grantHarris/ProsthesisBatteryPack/LightPanels/DXF's/SBX connector outline - Right.DXF

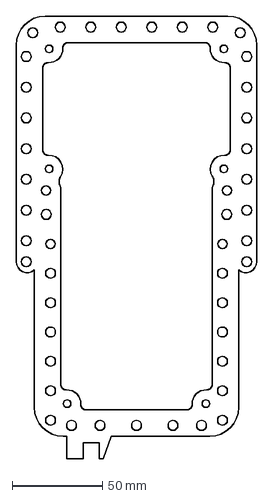
[picture p1: CAD file, 2016-11-01]
LightPanels/DXF's/SBX connector outline - Right.DXF
133.0 x 244.9 mm
