grantHarris/ProsthesisBatteryPack/LightPanels/DXF's/SBX connector outline - Left.DXF

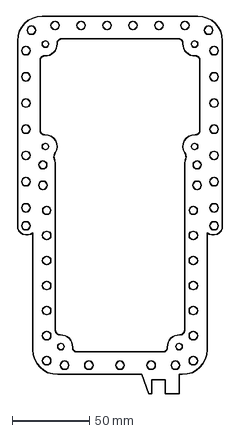
[picture p2: CAD file, 2016-11-01]
LightPanels/DXF's/SBX connector outline - Left.DXF
133.0 x 244.9 mm
