grantHarris/ProsthesisBatteryPack/LightPanels/DXF's/power indicator_right.DXF

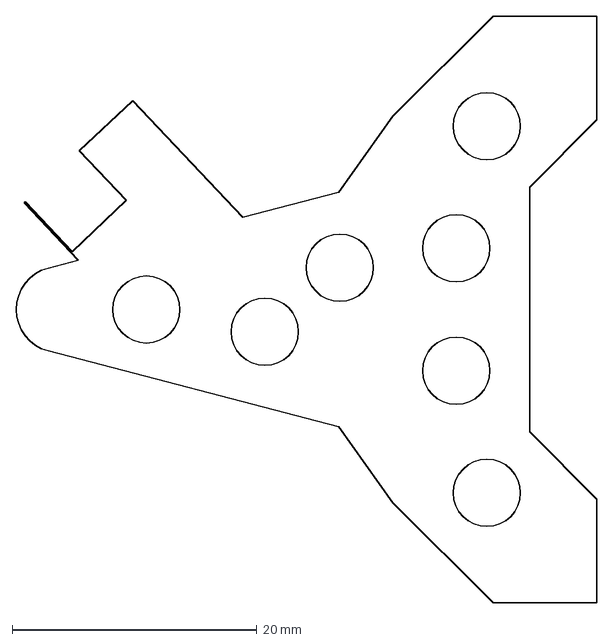
[picture p3: CAD file, 2016-11-01]
LightPanels/DXF's/power indicator_right.DXF
47.5 x 48.0 mm
