grantHarris/ProsthesisBatteryPack/LightPanels/DXF's/SOC level indicator.DXF

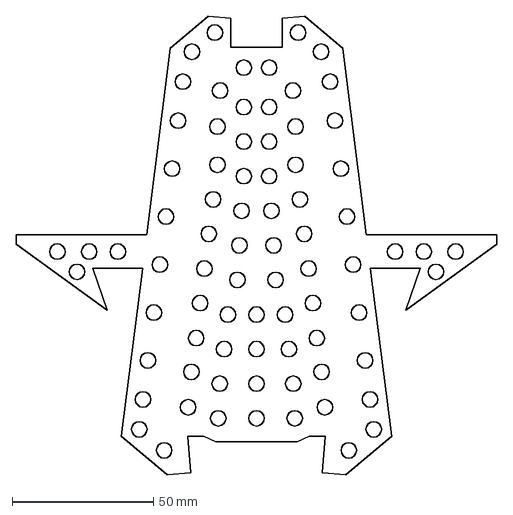
[picture p4: CAD file, 2016-11-01]
LightPanels/DXF's/SOC level indicator.DXF
170.0 x 162.3 mm
