grantHarris/ProsthesisBatteryPack/LightPanels/DXF's/power indicator_left.DXF

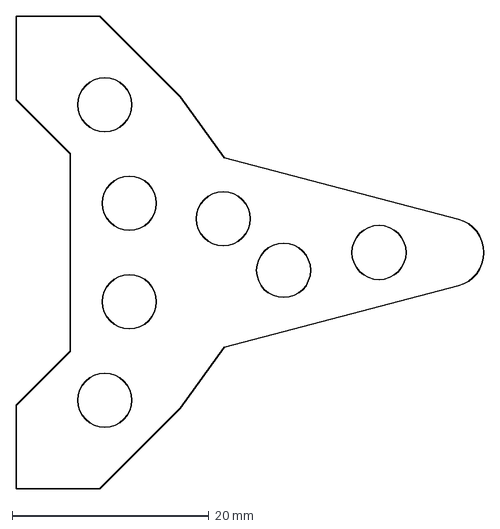
[picture p5: CAD file, 2016-11-01]
LightPanels/DXF's/power indicator_left.DXF
47.5 x 48.0 mm
