grantHarris/ProsthesisBatteryPack/CANShield/CANShield.brd

## EAGLE design CANShield/CANShield.brd (2016-12-07)

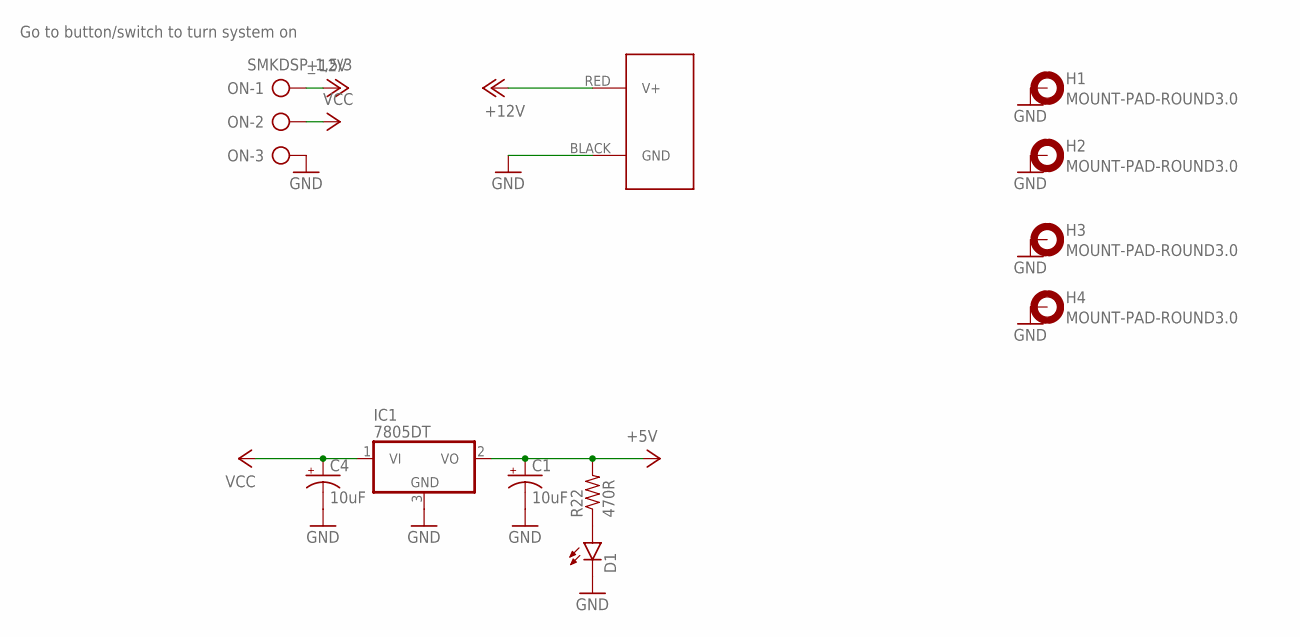
[picture p6: schematic CANShield.sch, sheet 1]

Parts:
C1, C4: 10uF; PANASONIC_C
D1: LED1206; LED-1206
H1, H2, H3, H4: MOUNT-PAD-ROUND3.0; 3,0-PAD
IC1: 7805DT; TO252
J2: POWERPOLE_POWER25A_HORIZONTAL_G2; POWERPOLE_PAIR_25A_HORIZ_G2
ON: SMKDSP_1,5/3
R22: 470R; 0603-RES

Connections:
+5V: C1.+, IC1.2 (VO), R22.2; also elsewhere on the board
+12V: J2.RED (V+), ON.1; also elsewhere on the board
GND: C1.-, C4.-, D1.C, H1.B3,0, H2.B3,0, H3.B3,0, H4.B3,0, IC1.3 (GND), J2.BLACK (GND), ON.3; also elsewhere on the board
unnamed: D1.A, R22.1
VCC: C4.+, IC1.1 (VI), ON.2

Notes on the sheet:
Go to button/switch to turn system on

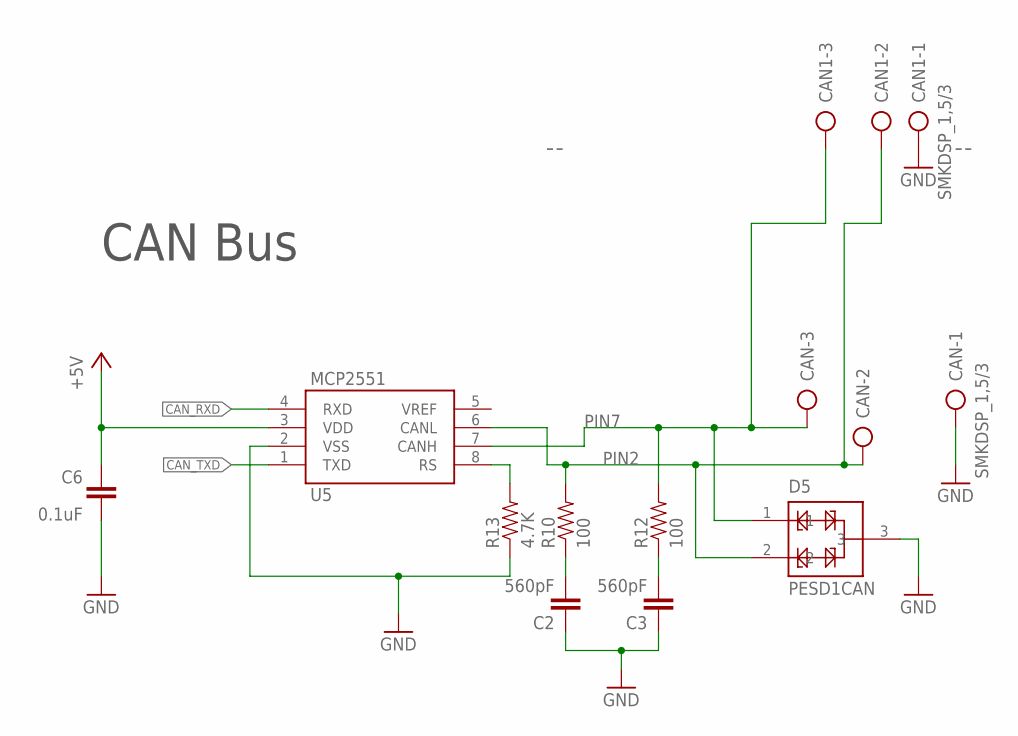
[picture p7: schematic CANShield.sch, sheet 2]

Parts:
C2, C3: 560pF; 0603-CAP
C6: 0.1uF; 0603-CAP
CAN, CAN1: SMKDSP_1,5/3
D5: PESD1CAN; SOT23-3@1
R10, R12: 100; 0603-RES@1
R13: 4.7K; 0603-RES@1
U5: MCP2551; SO08

Connections:
+5V: C6.2, U5.3 (VDD); also elsewhere on the board
CAN_RXD: U5.4 (RXD); also elsewhere on the board
CAN_TXD: U5.1 (TXD); also elsewhere on the board
GND: C2.1, C3.1, C6.1, CAN.1, CAN1.1, D5.3, R13.1, U5.2 (VSS); also elsewhere on the board
unnamed: C2.2, R10.1
unnamed: C3.2, R12.1
unnamed: R13.2, U5.8 (RS)
PIN2: CAN.2, CAN1.2, D5.2, R10.2, U5.6 (CANL)
PIN7: CAN.3, CAN1.3, D5.1, R12.2, U5.7 (CANH)

Notes on the sheet:
CAN Bus

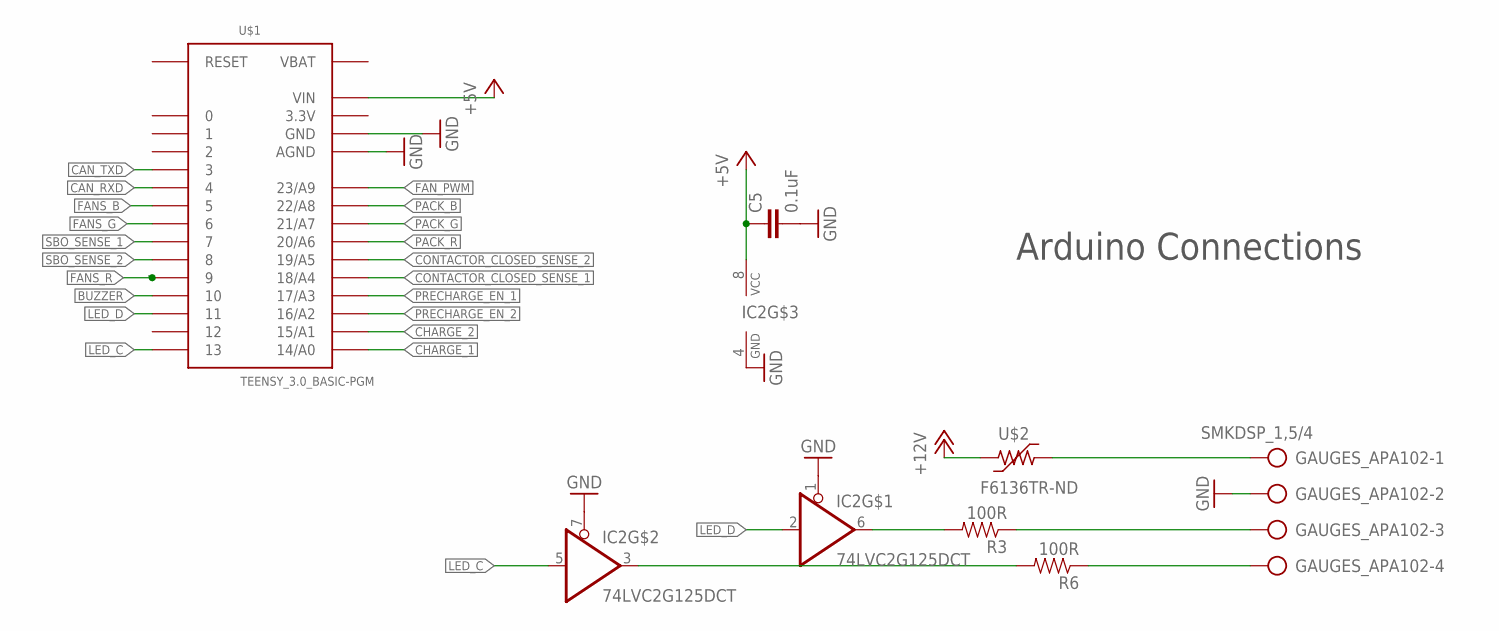
[picture p8: schematic CANShield.sch, sheet 3]

Parts:
C5: 0.1uF; 0603-CAP
GAUGES_APA102: SMKDSP_1,5/4
IC2: 74LVC2G125DCT; SSOP08
R3, R6: 100R; 0603-RES
U$1: TEENSY_3.0_BASIC-PGM
U$2: F6136TR-ND; 2920L

Connections:
3.3V: U$1.3.3V, U$1.3.3V1 (3.3V)
+5V: C5.1, IC2.8 (VCC), U$1.VIN; also elsewhere on the board
+12V: U$2.1; also elsewhere on the board
BUZZER: U$1.10; also elsewhere on the board
CAN_RXD: U$1.4; also elsewhere on the board
CAN_TXD: U$1.3; also elsewhere on the board
CHARGE_1: U$1.14/A0; also elsewhere on the board
CHARGE_2: U$1.15/A1; also elsewhere on the board
CONTACTOR_CLOSED_SENSE_1: U$1.18/A4; also elsewhere on the board
CONTACTOR_CLOSED_SENSE_2: U$1.19/A5; also elsewhere on the board
FANS_B: U$1.5; also elsewhere on the board
FANS_G: U$1.6; also elsewhere on the board
FANS_R: U$1.9; also elsewhere on the board
FAN_PWM: U$1.23/A9; also elsewhere on the board
GND: C5.2, GAUGES_APA102.2, IC2.1 (OE), IC2.4 (GND), IC2.7 (OE), U$1.AGND, U$1.GND, U$1.GND1 (GND); also elsewhere on the board
LED_C: IC2.5 (I), U$1.13
LED_D: IC2.2 (I), U$1.11
unnamed: IC2.3 (O), R6.2
unnamed: GAUGES_APA102.3, R3.1
unnamed: GAUGES_APA102.4, R6.1
unnamed: IC2.6 (O), R3.2
unnamed: GAUGES_APA102.1, U$2.2
PACK_B: U$1.22/A8; also elsewhere on the board
PACK_G: U$1.21/A7; also elsewhere on the board
PACK_R: U$1.20/A6; also elsewhere on the board
PRECHARGE_EN_1: U$1.17/A3; also elsewhere on the board
PRECHARGE_EN_2: U$1.16/A2; also elsewhere on the board
SBO_SENSE_1: U$1.7; also elsewhere on the board
SBO_SENSE_2: U$1.8; also elsewhere on the board
VBAT: U$1.VBAT

Notes on the sheet:
Arduino Connections

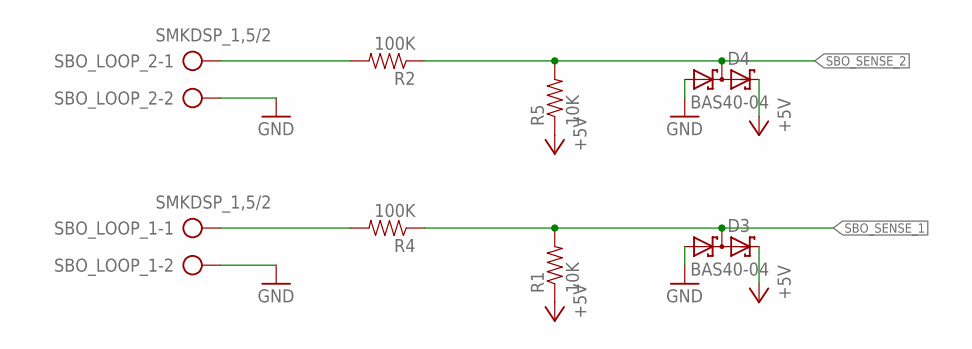
[picture p9: schematic CANShield.sch, sheet 4]

Parts:
D3, D4: BAS40-04; SOT23
R1, R5: 10K; 0603-RES
R2, R4: 100K; 0603-RES
SBO_LOOP_1, SBO_LOOP_2: SMKDSP_1,5/2

Connections:
+5V: D3.2 (C2), D4.2 (C2), R1.1, R5.1; also elsewhere on the board
GND: D3.1 (A1), D4.1 (A1), SBO_LOOP_1.2, SBO_LOOP_2.2; also elsewhere on the board
unnamed: R2.2, SBO_LOOP_2.1
unnamed: R4.2, SBO_LOOP_1.1
SBO_SENSE_1: D3.3 (C1A2), R1.2, R4.1; also elsewhere on the board
SBO_SENSE_2: D4.3 (C1A2), R2.1, R5.2; also elsewhere on the board

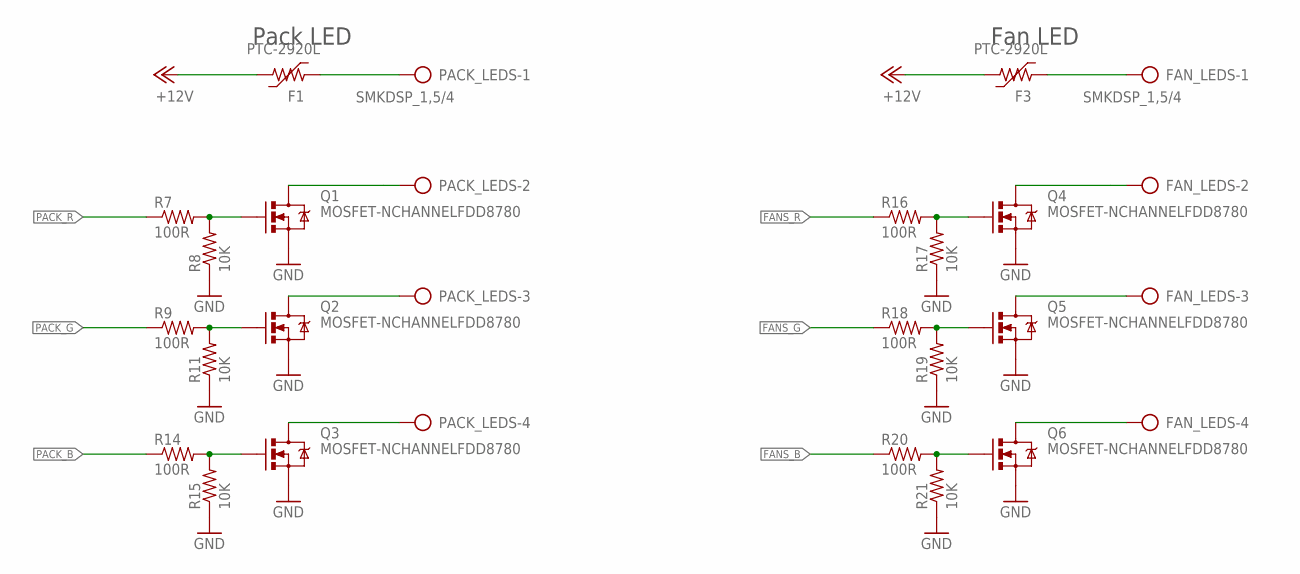
[picture p10: schematic CANShield.sch, sheet 5]

Parts:
F1, F3: PTC-2920L; 2920L
FAN_LEDS: SMKDSP_1,5/4
PACK_LEDS: SMKDSP_1,5/4
Q1, Q2, Q3, Q4, Q5, Q6: MOSFET-NCHANNELFDD8780; DPAK
R7, R9, R14, R16, R18, R20: 100R; 0603-RES
R8, R11, R15, R17, R19, R21: 10K; 0603-RES

Connections:
+12V: F1.2, F3.2; also elsewhere on the board
FANS_B: R20.1; also elsewhere on the board
FANS_G: R18.1; also elsewhere on the board
FANS_R: R16.1; also elsewhere on the board
GND: Q1.3 (S), Q2.3 (S), Q3.3 (S), Q4.3 (S), Q5.3 (S), Q6.3 (S), R8.1, R11.1, R15.1, R17.1, R19.1, R21.1; also elsewhere on the board
unnamed: PACK_LEDS.2, Q1.4 (D)
unnamed: F1.1, PACK_LEDS.1
unnamed: PACK_LEDS.3, Q2.4 (D)
unnamed: PACK_LEDS.4, Q3.4 (D)
unnamed: Q1.1 (G), R7.2, R8.2
unnamed: Q2.1 (G), R9.2, R11.2
unnamed: Q3.1 (G), R14.2, R15.2
unnamed: F3.1, FAN_LEDS.1
unnamed: FAN_LEDS.2, Q4.4 (D)
unnamed: FAN_LEDS.3, Q5.4 (D)
unnamed: FAN_LEDS.4, Q6.4 (D)
unnamed: Q4.1 (G), R16.2, R17.2
unnamed: Q5.1 (G), R18.2, R19.2
unnamed: Q6.1 (G), R20.2, R21.2
PACK_B: R14.1; also elsewhere on the board
PACK_G: R9.1; also elsewhere on the board
PACK_R: R7.1; also elsewhere on the board

Notes on the sheet:
Pack LED
Fan LED

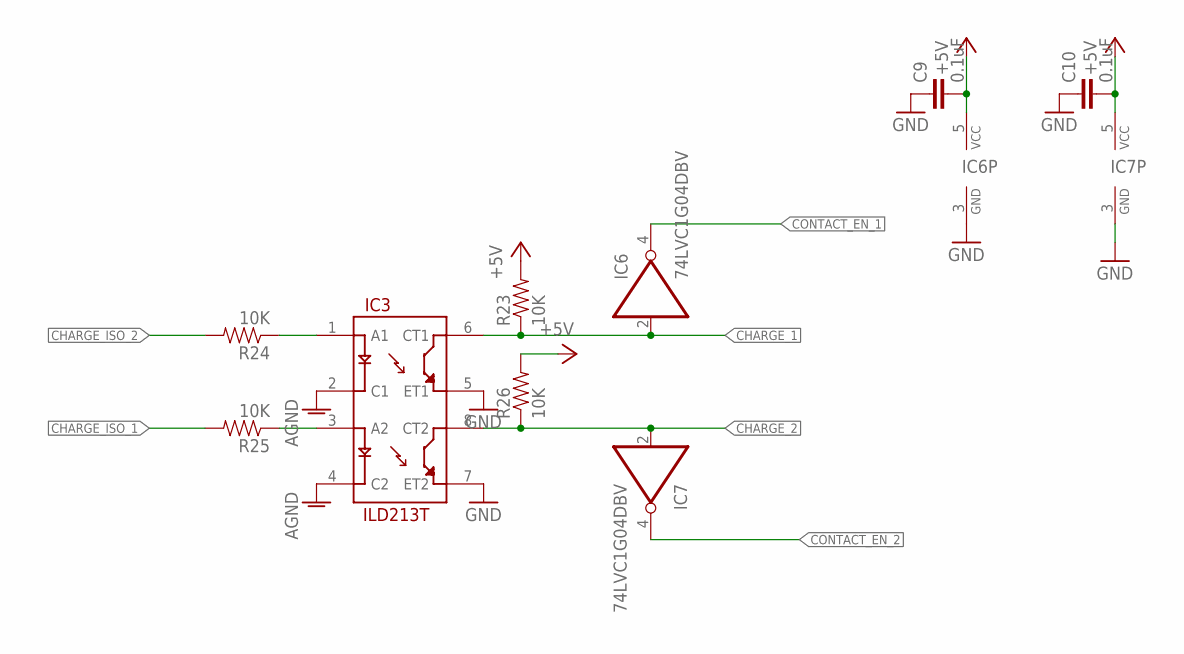
[picture p11: schematic CANShield.sch, sheet 6]

Parts:
C9, C10: 0.1uF; 0603-CAP
IC3: ILD213T; SO08
IC6, IC7: 74LVC1G04DBV; SOT23-5
R23, R24, R25, R26: 10K; 0603-RES

Connections:
+5V: C9.2, C10.2, IC6.5 (VCC), IC7.5 (VCC), R23.2, R26.2; also elsewhere on the board
AGND: IC3.2 (C1), IC3.4 (C2); also elsewhere on the board
CHARGE_1: IC3.6 (CT1), IC6.2 (I), R23.1; also elsewhere on the board
CHARGE_2: IC3.8 (CT2), IC7.2 (I), R26.1; also elsewhere on the board
CHARGE_ISO_1: R25.2; also elsewhere on the board
CHARGE_ISO_2: R24.2; also elsewhere on the board
CONTACT_EN_1: IC6.4 (O); also elsewhere on the board
CONTACT_EN_2: IC7.4 (O); also elsewhere on the board
GND: C9.1, C10.1, IC3.5 (ET1), IC3.7 (ET2), IC6.3 (GND), IC7.3 (GND); also elsewhere on the board
unnamed: IC3.3 (A2), R25.1
unnamed: IC3.1 (A1), R24.1

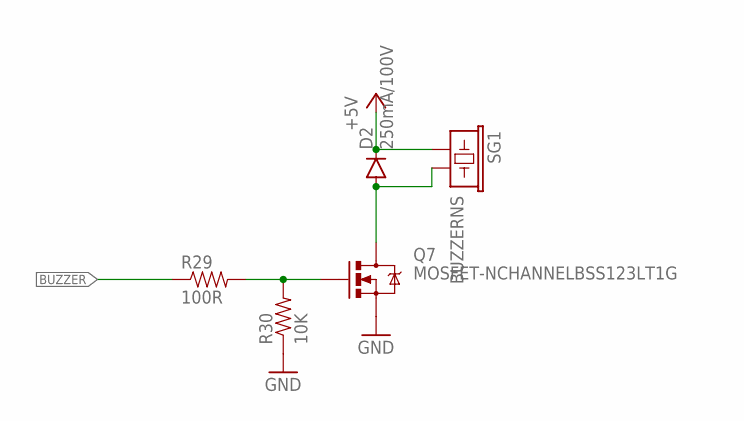
[picture p12: schematic CANShield.sch, sheet 7]

Parts:
D2: 250mA/100V; SOD-323
Q7: MOSFET-NCHANNELBSS123LT1G; SOT23
R29: 100R; 0603-RES
R30: 10K; 0603-RES
SG1: BUZZERNS; BUZZER-12MM-NS

Connections:
+5V: D2.C, SG1.+ (1); also elsewhere on the board
BUZZER: R29.1; also elsewhere on the board
GND: Q7.2 (S), R30.1; also elsewhere on the board
unnamed: D2.A, Q7.3 (D), SG1.- (2)
unnamed: Q7.1 (G), R29.2, R30.2

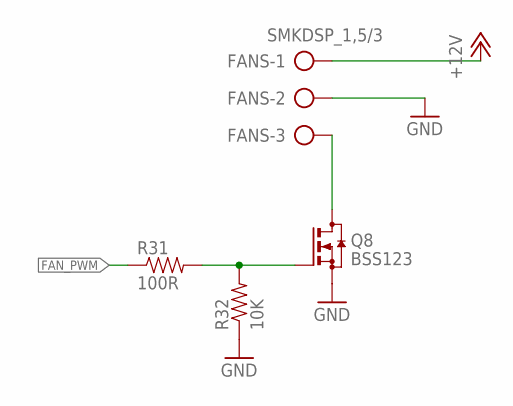
[picture p13: schematic CANShield.sch, sheet 8]

Parts:
FANS: SMKDSP_1,5/3
Q8: BSS123; SOT23
R31: 100R; 0603-RES
R32: 10K; 0603-RES

Connections:
+12V: FANS.1; also elsewhere on the board
FAN_PWM: R31.1; also elsewhere on the board
GND: FANS.2, Q8.2 (S), R32.1; also elsewhere on the board
unnamed: Q8.1 (G), R31.2, R32.2
unnamed: FANS.3, Q8.3 (D)

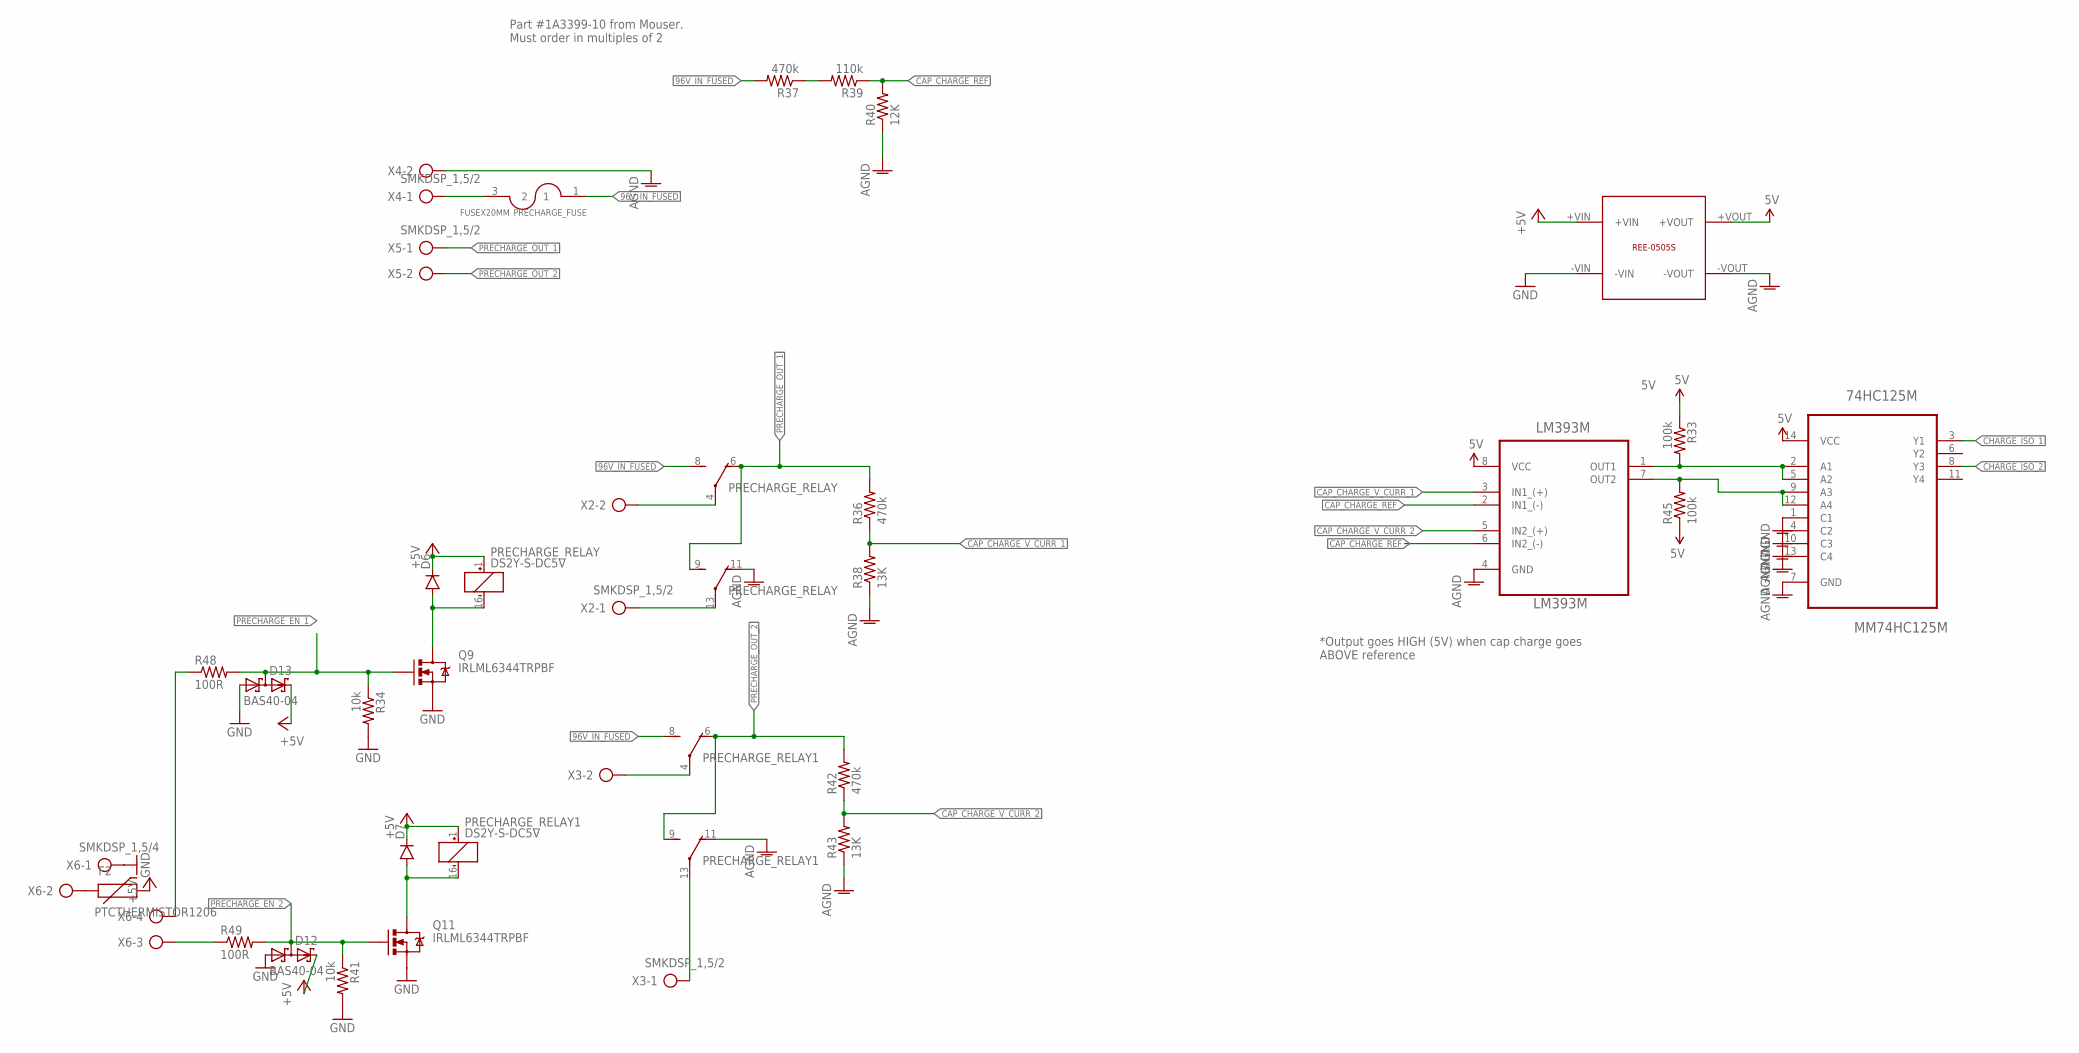
[picture p14: schematic CANShield.sch, sheet 9]

Parts:
74HC125M: MM74HC125M; SOIC127P600X175-14N
D6, D7: DIODESOD123; SOD-123
D12, D13: BAS40-04; SOT23
F2: PTCTHERMISTOR1206; PTC-1206
LM393M: LM393M; SOIC127P600X180-8N
PRECHARGE_FUSE: FUSEX20MM; FUSE_5MM
PRECHARGE_RELAY, PRECHARGE_RELAY1: DS2Y-S-DC5V; DS2Y
Q9, Q11: IRLML6344TRPBF; SOT23
R33, R45: 100k; 0603-RES
R34, R41: 10k; 0603-RES
R36, R37, R42: 470k; 0805
R38, R43: 13K; 0805
R39: 110k; 0805
R40: 12K; 0805
R48, R49: 100R; 0603-RES
U$5: REE-0505S
X2, X3, X4, X5: SMKDSP_1,5/2
X6: SMKDSP_1,5/4

Connections:
5V: 74HC125M.14 (VCC), LM393M.8 (VCC), R33.1, R45.1, U$5.+VOUT
96V_IN_FUSED: PRECHARGE_FUSE.1, PRECHARGE_RELAY.8 (S), PRECHARGE_RELAY1.8 (S), R37.2
+5V: D6.C, D7.C, D12.2 (C2), D13.2 (C2), F2.2, PRECHARGE_RELAY.1 (+), PRECHARGE_RELAY1.1 (+), U$5.+VIN; also elsewhere on the board
AGND: 74HC125M.1 (C1), 74HC125M.4 (C2), 74HC125M.7 (GND), 74HC125M.10 (C3), 74HC125M.13 (C4), LM393M.4 (GND), PRECHARGE_RELAY.11 (O), PRECHARGE_RELAY1.11 (O), R38.1, R40.1, R43.1, U$5.-VOUT, X4.2; also elsewhere on the board
CAP_CHARGE_REF: LM393M.2 (IN1_(-)), LM393M.6 (IN2_(-)), R39.1, R40.2
CAP_CHARGE_V_CURR_1: LM393M.3 (IN1_(+)), R36.1, R38.2
CAP_CHARGE_V_CURR_2: LM393M.5 (IN2_(+)), R42.1, R43.2
CHARGE_ISO_1: 74HC125M.3 (Y1); also elsewhere on the board
CHARGE_ISO_2: 74HC125M.8 (Y3); also elsewhere on the board
GND: D12.1 (A1), D13.1 (A1), Q9.2 (S), Q11.2 (S), R34.2, R41.2, U$5.-VIN, X6.1; also elsewhere on the board
unnamed: R37.1, R39.2
unnamed: 74HC125M.9 (A3), 74HC125M.12 (A4), LM393M.7 (OUT2), R45.2
unnamed: R48.1, X6.4
unnamed: R49.1, X6.3
unnamed: PRECHARGE_RELAY.13, X2.1
unnamed: PRECHARGE_RELAY1.13, X3.1
unnamed: PRECHARGE_FUSE.3 (2), X4.1
unnamed: F2.1, X6.2
PRECHARGE_EN_1: D13.3 (C1A2), Q9.1 (G), R34.1, R48.2; also elsewhere on the board
PRECHARGE_EN_2: D12.3 (C1A2), Q11.1 (G), R41.1, R49.2; also elsewhere on the board
PRECHARGE_OUT_1: PRECHARGE_RELAY.6 (O), PRECHARGE_RELAY.9 (S), R36.2, X5.1
PRECHARGE_OUT_2: PRECHARGE_RELAY1.6 (O), PRECHARGE_RELAY1.9 (S), R42.2, X5.2
PRECHARGE_RESISTOR_IN_1: PRECHARGE_RELAY.4, X2.2
PRECHARGE_RESISTOR_IN_2: PRECHARGE_RELAY1.4, X3.2
PRECH_DRAIN: D6.A, PRECHARGE_RELAY.16 (-), Q9.3 (D)
PRECH_DRAIN1: D7.A, PRECHARGE_RELAY1.16 (-), Q11.3 (D)
PRECH_STATE_TO_BUFF: 74HC125M.2 (A1), 74HC125M.5 (A2), LM393M.1 (OUT1), R33.2

Notes on the sheet:
*Output goes HIGH (5V) when cap charge goes ABOVE reference
Part #1A3399-10 from Mouser. Must order in multiples of 2

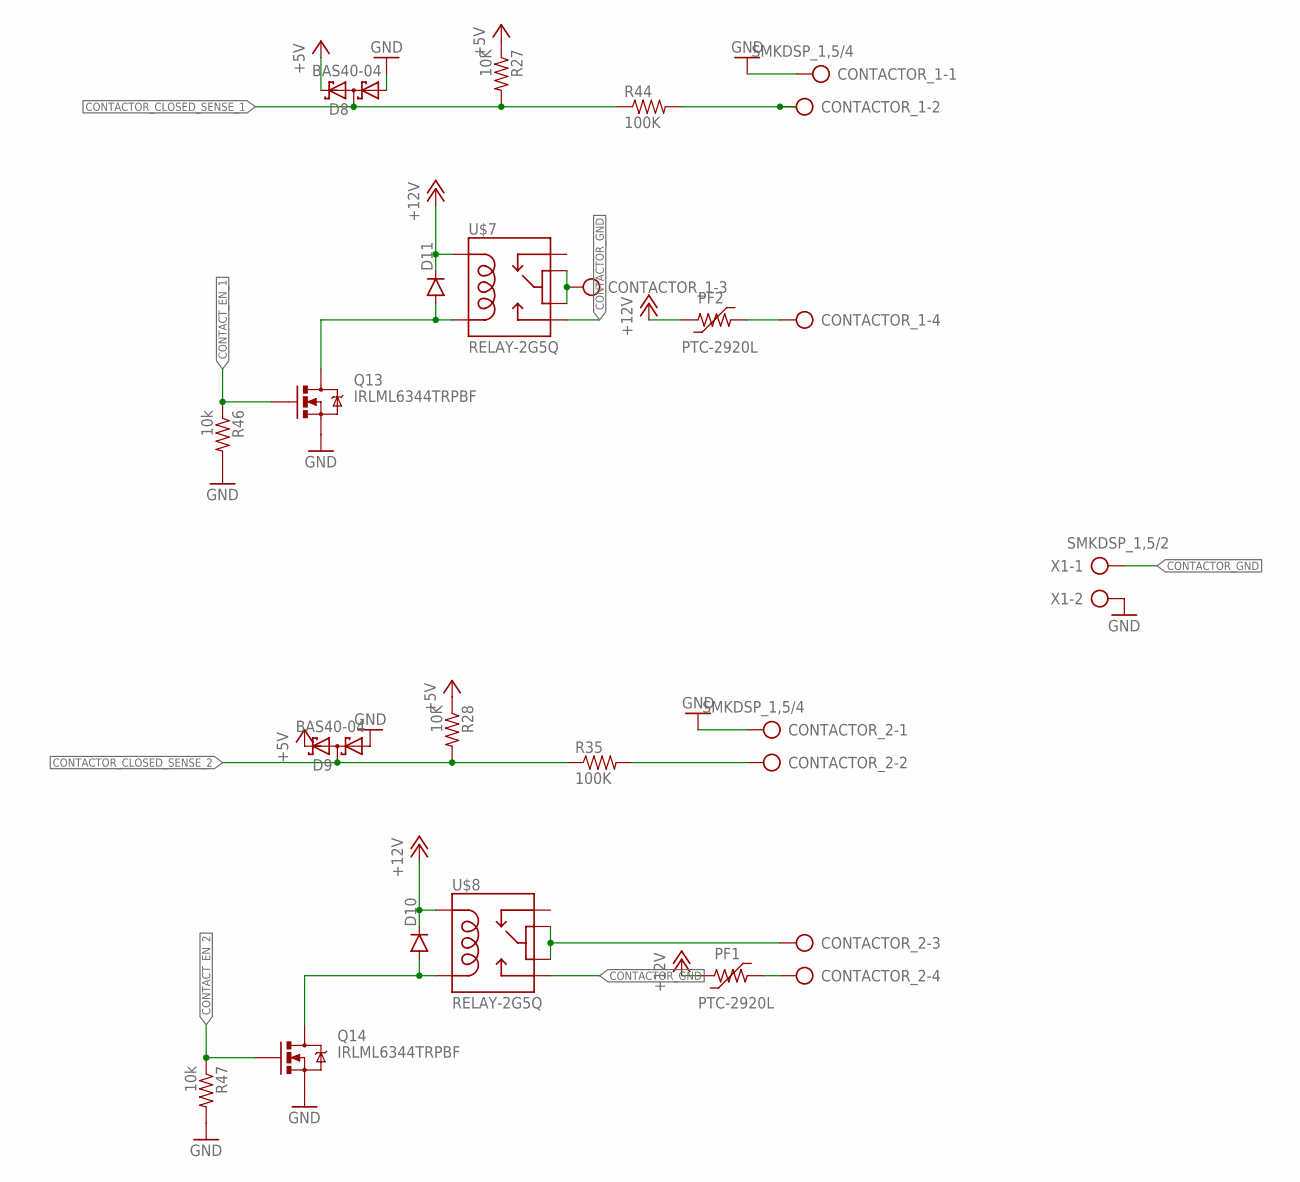
[picture p15: schematic CANShield.sch, sheet 10]

Parts:
CONTACTOR_1, CONTACTOR_2: SMKDSP_1,5/4
D8, D9: BAS40-04; SOT23
D10, D11: DIODESOD123; SOD-123
PF1, PF2: PTC-2920L; 2920L
Q13, Q14: IRLML6344TRPBF; SOT23
R27, R28: 10K; 0603-RES
R35, R44: 100K; 0603-RES
R46, R47: 10k; 0603-RES
U$7, U$8: RELAY-2G5Q; RELAY-G5V
X1: SMKDSP_1,5/2

Connections:
+5V: D8.2 (C2), D9.2 (C2), R27.1, R28.1; also elsewhere on the board
+12V: D10.C, D11.C, PF1.1, PF2.1, U$7.2, U$8.2; also elsewhere on the board
CONTACTOR_CLOSED_SENSE_1: D8.3 (C1A2), R27.2, R44.1; also elsewhere on the board
CONTACTOR_CLOSED_SENSE_2: D9.3 (C1A2), R28.2, R35.1; also elsewhere on the board
CONTACTOR_GND: U$7.10, U$8.10, X1.1
CONTACT_EN_1: Q13.1 (G), R46.1; also elsewhere on the board
CONTACT_EN_2: Q14.1 (G), R47.1; also elsewhere on the board
GND: CONTACTOR_1.1, CONTACTOR_2.1, D8.1 (A1), D9.1 (A1), Q13.2 (S), Q14.2 (S), R46.2, R47.2, X1.2; also elsewhere on the board
unnamed: D10.A, Q14.3 (D), U$8.9
unnamed: D11.A, Q13.3 (D), U$7.9
unnamed: CONTACTOR_1.3, U$7.5, U$7.6
unnamed: CONTACTOR_2.3, U$8.5, U$8.6
unnamed: CONTACTOR_1.4, PF2.2
unnamed: CONTACTOR_2.4, PF1.2
unnamed: CONTACTOR_2.2, R35.2
unnamed: CONTACTOR_1.2, R44.2

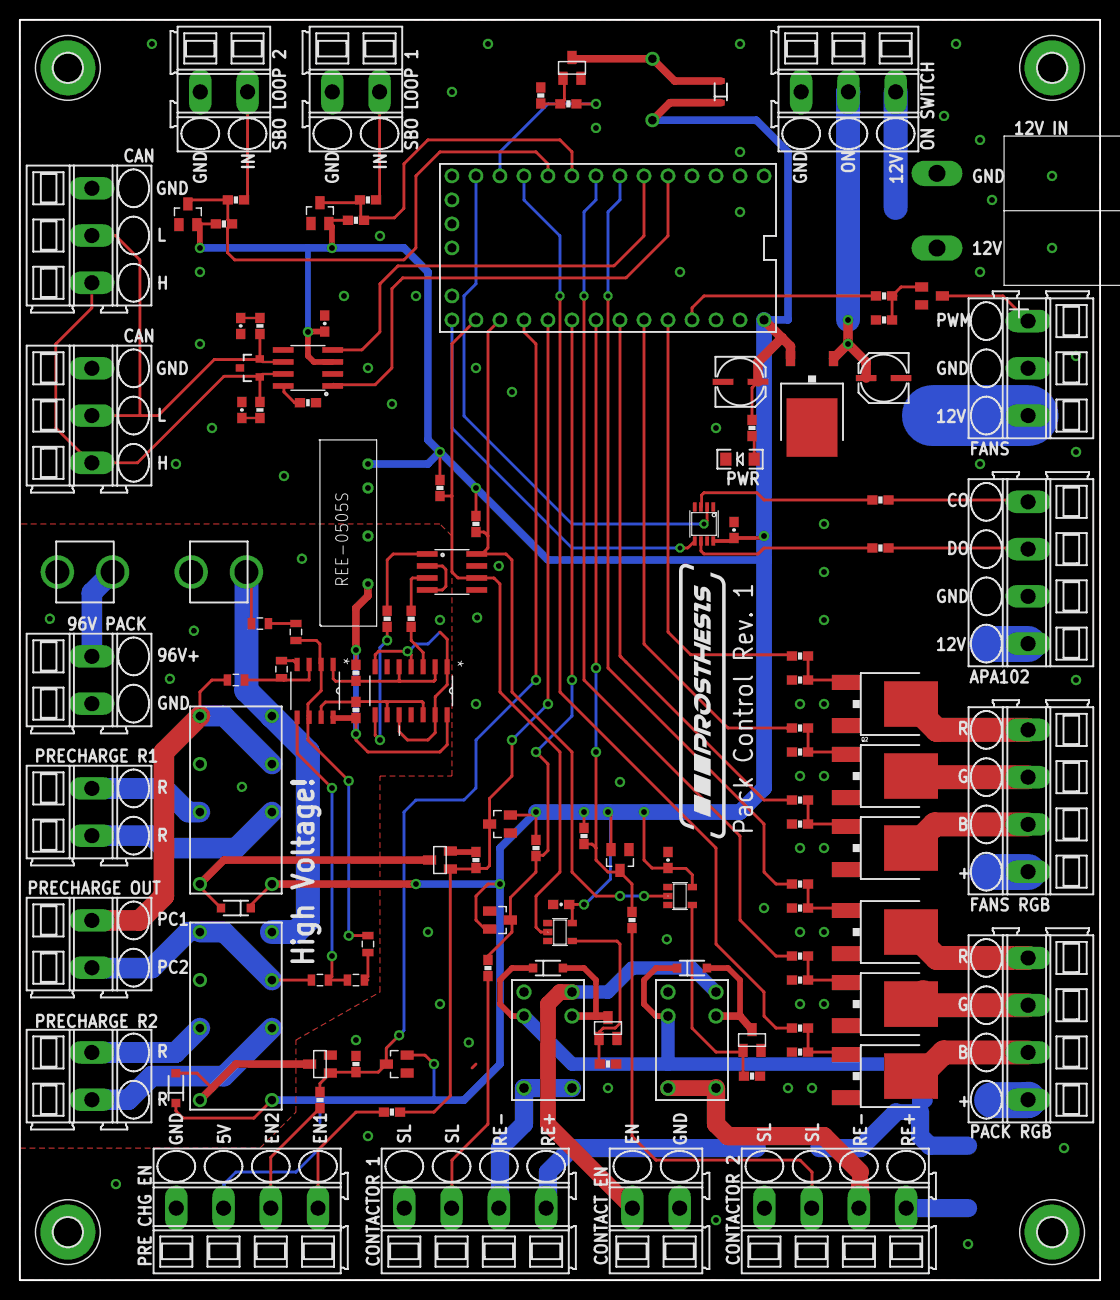
[picture p16: board CANShield.brd from above]

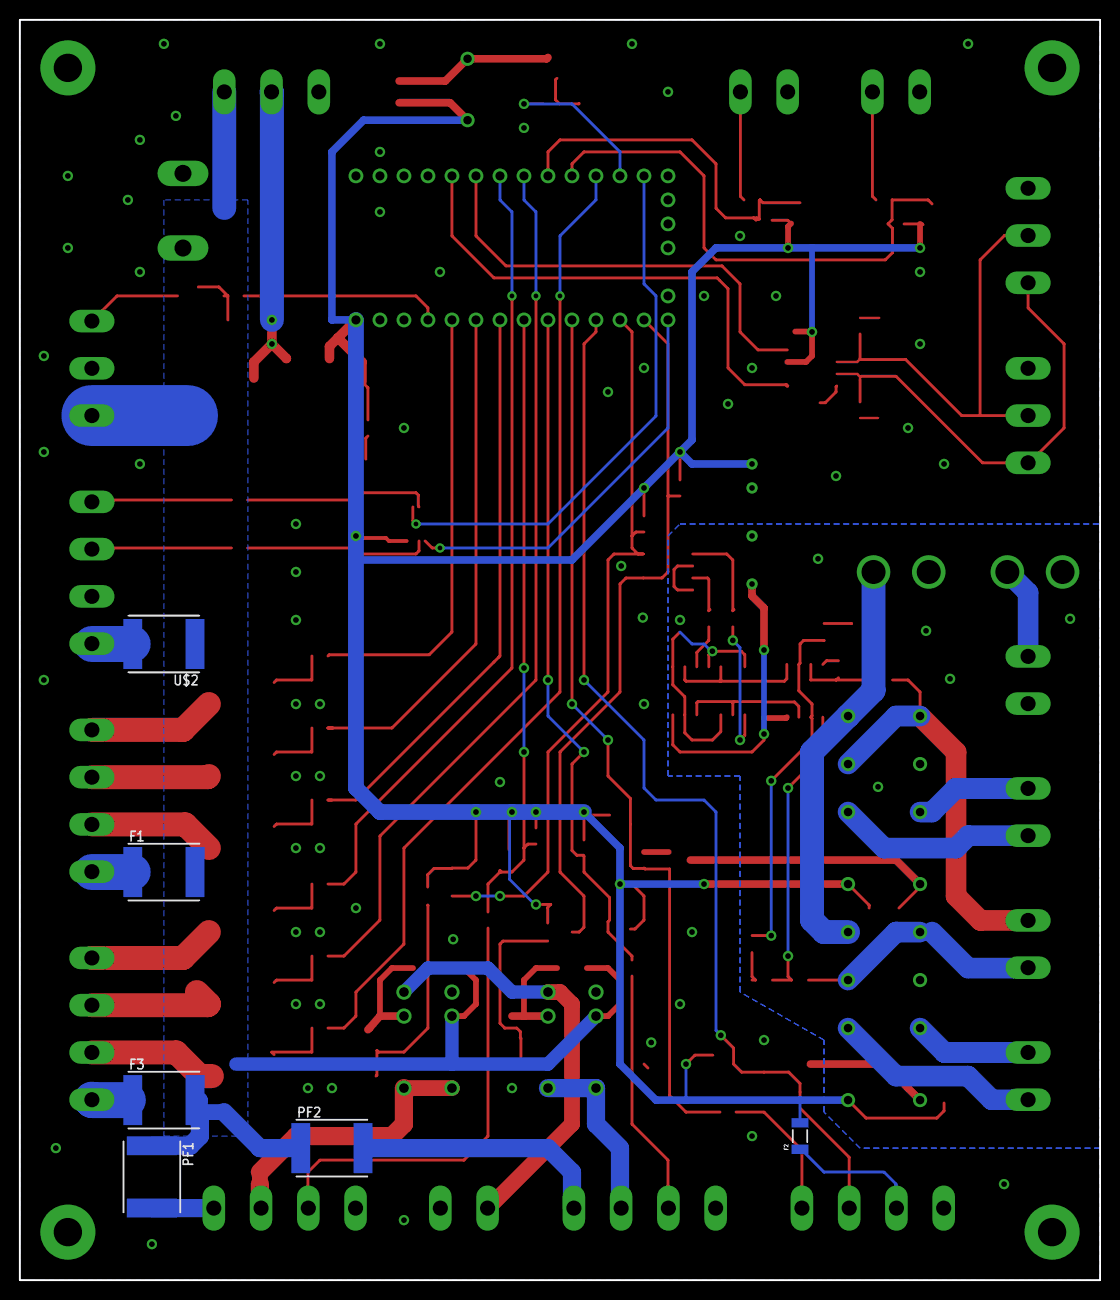
[picture p17: board CANShield.brd from below]

Board: 2 copper layers, 114.3 x 133.3 mm, 127 parts (6 on the bottom side), 92 nets.

Other parts of the board:
U$4: PROS_LOGO
