grantHarris/ProsthesisBatteryPack/LightPanels/power_indicator_left.brd

## EAGLE design LightPanels/power_indicator_left.brd (2016-11-16)

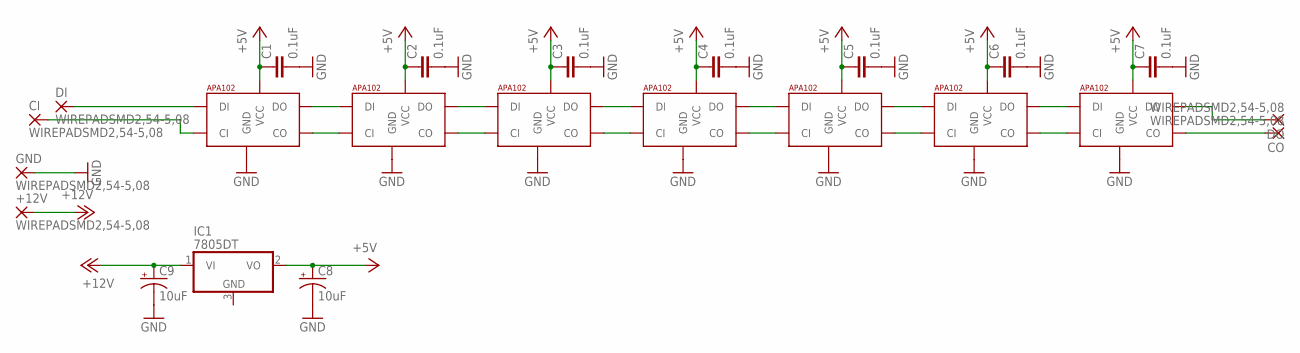
[picture p18: schematic power_indicator_left.sch]

Parts:
+12V: WIREPADSMD2,54-5,08; SMD2,54-5,08
C1, C2, C3, C4, C5, C6, C7: 0.1uF; 0603-CAP
C8, C9: 10uF; EIA3216
CI: WIREPADSMD2,54-5,08; SMD2,54-5,08
CO: WIREPADSMD2,54-5,08; SMD2,54-5,08
DI: WIREPADSMD2,54-5,08; SMD2,54-5,08
DO: WIREPADSMD2,54-5,08; SMD2,54-5,08
GND: WIREPADSMD2,54-5,08; SMD2,54-5,08
IC1: 7805DT; TO252
U$1, U$2, U$3, U$4, U$5, U$6, U$7: APA1025050; APA102_5050

Connections:
+5V: C1.1, C2.1, C3.1, C4.1, C5.1, C6.1, C7.1, C8.A (+), IC1.2 (VO), U$1.1 (VCC), U$2.1 (VCC), U$3.1 (VCC), U$4.1 (VCC), U$5.1 (VCC), U$6.1 (VCC), U$7.1 (VCC)
+12V: +12V.1, C9.A (+), IC1.1 (VI)
GND: C1.2, C2.2, C3.2, C4.2, C5.2, C6.2, C7.2, C8.C (-), C9.C (-), GND.1, U$1.6 (GND), U$2.6 (GND), U$3.6 (GND), U$4.6 (GND), U$5.6 (GND), U$6.6 (GND), U$7.6 (GND)
unnamed: U$1.2 (CO), U$2.5 (CI)
unnamed: U$1.3 (DO), U$2.4 (DI)
unnamed: U$2.2 (CO), U$3.5 (CI)
unnamed: U$2.3 (DO), U$3.4 (DI)
unnamed: U$3.2 (CO), U$4.5 (CI)
unnamed: U$3.3 (DO), U$4.4 (DI)
unnamed: U$4.2 (CO), U$5.5 (CI)
unnamed: U$4.3 (DO), U$5.4 (DI)
unnamed: U$5.2 (CO), U$6.5 (CI)
unnamed: U$5.3 (DO), U$6.4 (DI)
unnamed: U$6.2 (CO), U$7.5 (CI)
unnamed: U$6.3 (DO), U$7.4 (DI)
unnamed: CO.1, U$7.2 (CO)
unnamed: DO.1, U$7.3 (DO)
unnamed: DI.1, U$1.4 (DI)
unnamed: CI.1, U$1.5 (CI)

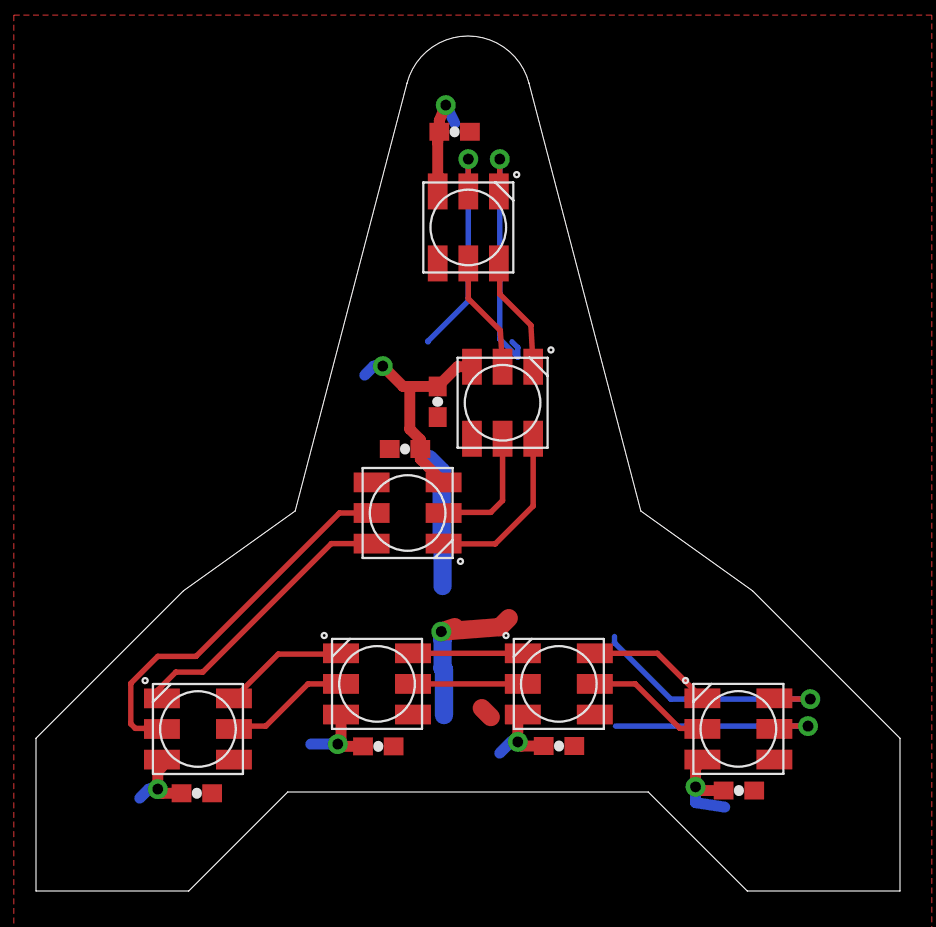
[picture p19: board power_indicator_left.brd from above]

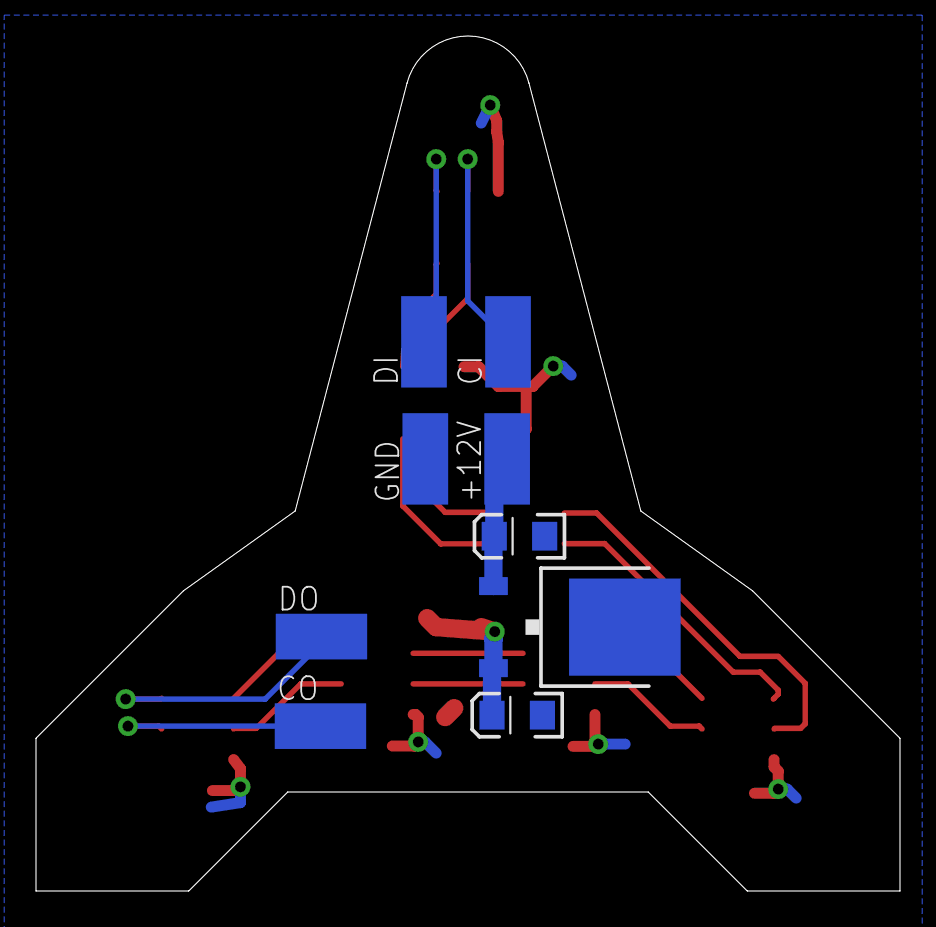
[picture p20: board power_indicator_left.brd from below]

Board: 2 copper layers, 48.0 x 47.5 mm, 23 parts (9 on the bottom side), 19 nets.
