grantHarris/ProsthesisBatteryPack/LightPanels/SBX_connector_outline.brd

## EAGLE design LightPanels/SBX_connector_outline.brd (2016-11-16)

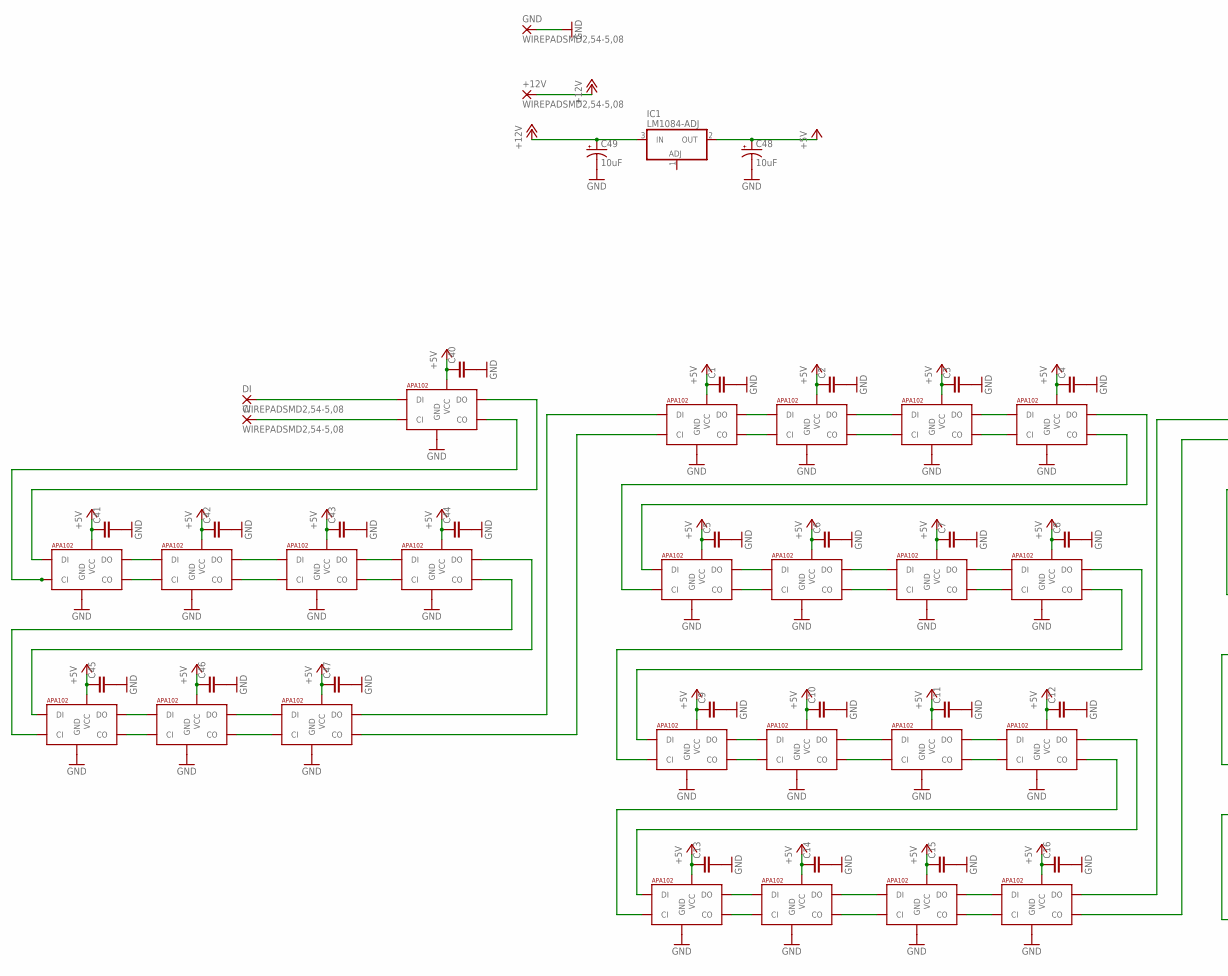
[picture p21: schematic SBX_connector_outline.sch, part in row 1, column 1]

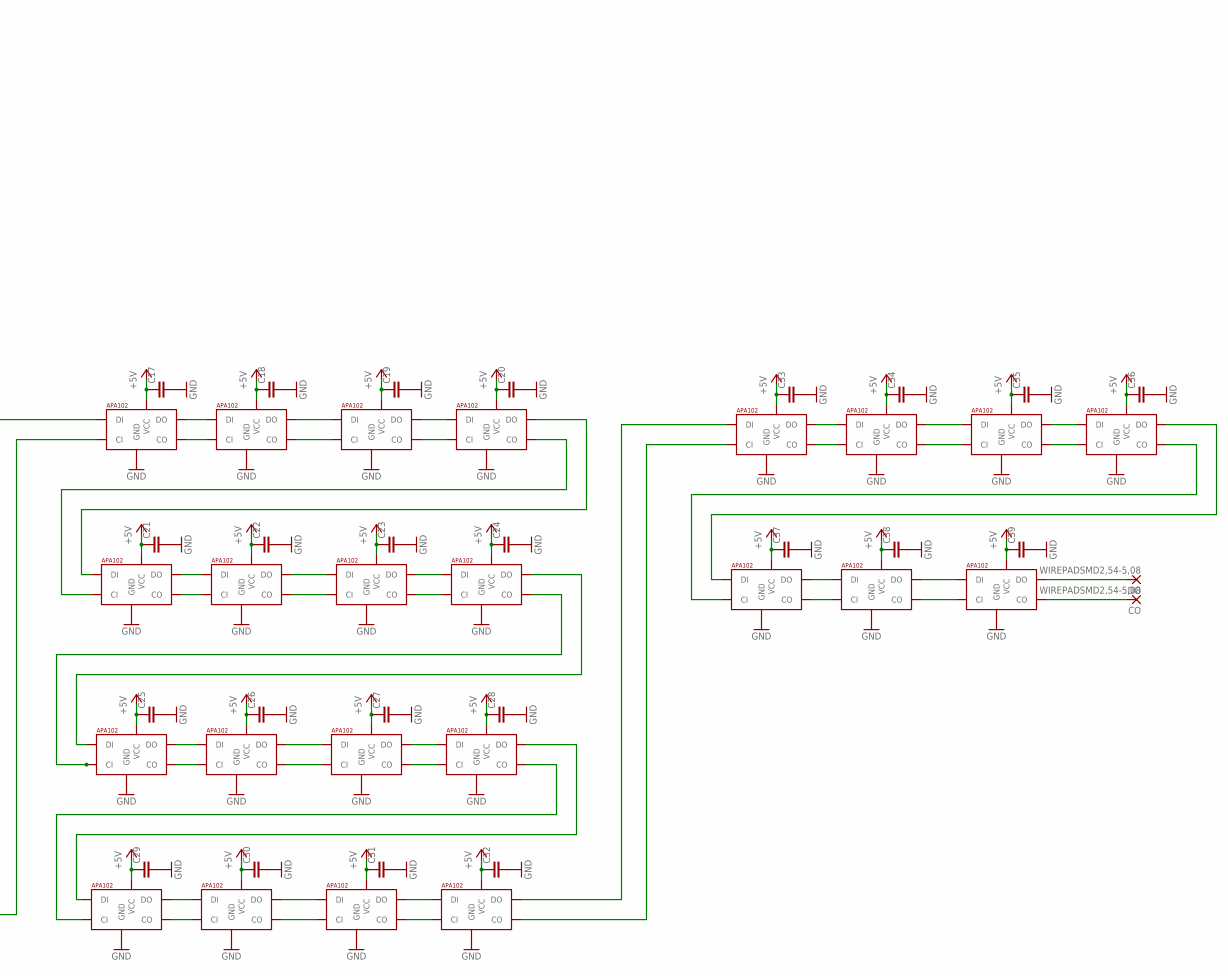
[picture p22: schematic SBX_connector_outline.sch, part in row 1, column 2]

Parts:
+12V: WIREPADSMD2,54-5,08; SMD2,54-5,08
C1, C2, C3, C4, C5, C6, C7, C8, C9, C10, C11, C12, C13, C14, C15, C16, C17, C18, C19, C20, C21, C22, C23, C24, C25, C26, C27, C28, C29, C30, C31, C32, C33, C34, C35, C36, C37, C38, C39, C40, C41, C42, C43, C44, C45, C46, C47: CAP0603-CAP; 0603-CAP
C48, C49: 10uF; EIA3216
CI: WIREPADSMD2,54-5,08; SMD2,54-5,08
CO: WIREPADSMD2,54-5,08; SMD2,54-5,08
DI: WIREPADSMD2,54-5,08; SMD2,54-5,08
DO: WIREPADSMD2,54-5,08; SMD2,54-5,08
GND: WIREPADSMD2,54-5,08; SMD2,54-5,08
IC1: LM1084-ADJ; TO263-3
U$1, U$2, U$3, U$4, U$5, U$6, U$7, U$8, U$9, U$10, U$11, U$12, U$13, U$14, U$15, U$16, U$17, U$18, U$19, U$20, U$21, U$22, U$23, U$24, U$25, U$26, U$27, U$28, U$29, U$30, U$31, U$32, U$33, U$34, U$35, U$36, U$37, U$38, U$39, U$40, U$41, U$42, U$43, U$44, U$45, U$46, U$47: APA1025050; APA102_5050

Connections:
+5V: C1.1, C2.1, C3.1, C4.1, C5.1, C6.1, C7.1, C8.1, C9.1, C10.1, C11.1, C12.1, C13.1, C14.1, C15.1, C16.1, C17.1, C18.1, C19.1, C20.1, C21.1, C22.1, C23.1, C24.1, C25.1, C26.1, C27.1, C28.1, C29.1, C30.1, C31.1, C32.1, C33.1, C34.1, C35.1, C36.1, C37.1, C38.1, C39.1, C40.1, C41.1, C42.1, C43.1, C44.1, C45.1, C46.1, C47.1, C48.A (+), IC1.2 (OUT), U$1.1 (VCC), U$2.1 (VCC), U$3.1 (VCC), U$4.1 (VCC), U$5.1 (VCC), U$6.1 (VCC), U$7.1 (VCC), U$8.1 (VCC), U$9.1 (VCC), U$10.1 (VCC), U$11.1 (VCC), U$12.1 (VCC), U$13.1 (VCC), U$14.1 (VCC), U$15.1 (VCC), U$16.1 (VCC), U$17.1 (VCC), U$18.1 (VCC), U$19.1 (VCC), U$20.1 (VCC), U$21.1 (VCC), U$22.1 (VCC), U$23.1 (VCC), U$24.1 (VCC), U$25.1 (VCC), U$26.1 (VCC), U$27.1 (VCC), U$28.1 (VCC), U$29.1 (VCC), U$30.1 (VCC), U$31.1 (VCC), U$32.1 (VCC), U$33.1 (VCC), U$34.1 (VCC), U$35.1 (VCC), U$36.1 (VCC), U$37.1 (VCC), U$38.1 (VCC), U$39.1 (VCC), U$40.1 (VCC), U$41.1 (VCC), U$42.1 (VCC), U$43.1 (VCC), U$44.1 (VCC), U$45.1 (VCC), U$46.1 (VCC), U$47.1 (VCC)
+12V: +12V.1, C49.A (+), IC1.3 (IN)
GND: C1.2, C2.2, C3.2, C4.2, C5.2, C6.2, C7.2, C8.2, C9.2, C10.2, C11.2, C12.2, C13.2, C14.2, C15.2, C16.2, C17.2, C18.2, C19.2, C20.2, C21.2, C22.2, C23.2, C24.2, C25.2, C26.2, C27.2, C28.2, C29.2, C30.2, C31.2, C32.2, C33.2, C34.2, C35.2, C36.2, C37.2, C38.2, C39.2, C40.2, C41.2, C42.2, C43.2, C44.2, C45.2, C46.2, C47.2, C48.C (-), C49.C (-), GND.1, U$1.6 (GND), U$2.6 (GND), U$3.6 (GND), U$4.6 (GND), U$5.6 (GND), U$6.6 (GND), U$7.6 (GND), U$8.6 (GND), U$9.6 (GND), U$10.6 (GND), U$11.6 (GND), U$12.6 (GND), U$13.6 (GND), U$14.6 (GND), U$15.6 (GND), U$16.6 (GND), U$17.6 (GND), U$18.6 (GND), U$19.6 (GND), U$20.6 (GND), U$21.6 (GND), U$22.6 (GND), U$23.6 (GND), U$24.6 (GND), U$25.6 (GND), U$26.6 (GND), U$27.6 (GND), U$28.6 (GND), U$29.6 (GND), U$30.6 (GND), U$31.6 (GND), U$32.6 (GND), U$33.6 (GND), U$34.6 (GND), U$35.6 (GND), U$36.6 (GND), U$37.6 (GND), U$38.6 (GND), U$39.6 (GND), U$40.6 (GND), U$41.6 (GND), U$42.6 (GND), U$43.6 (GND), U$44.6 (GND), U$45.6 (GND), U$46.6 (GND), U$47.6 (GND)
unnamed: U$1.3 (DO), U$2.4 (DI)
unnamed: U$1.2 (CO), U$2.5 (CI)
unnamed: U$2.3 (DO), U$3.4 (DI)
unnamed: U$2.2 (CO), U$3.5 (CI)
unnamed: U$3.3 (DO), U$4.4 (DI)
unnamed: U$3.2 (CO), U$4.5 (CI)
unnamed: U$4.3 (DO), U$5.4 (DI)
unnamed: U$4.2 (CO), U$5.5 (CI)
unnamed: U$5.3 (DO), U$6.4 (DI)
unnamed: U$5.2 (CO), U$6.5 (CI)
unnamed: U$6.3 (DO), U$7.4 (DI)
unnamed: U$6.2 (CO), U$7.5 (CI)
unnamed: U$7.3 (DO), U$8.4 (DI)
unnamed: U$7.2 (CO), U$8.5 (CI)
unnamed: U$8.3 (DO), U$9.4 (DI)
unnamed: U$8.2 (CO), U$9.5 (CI)
unnamed: U$9.3 (DO), U$10.4 (DI)
unnamed: U$9.2 (CO), U$10.5 (CI)
unnamed: U$10.3 (DO), U$11.4 (DI)
unnamed: U$10.2 (CO), U$11.5 (CI)
unnamed: U$11.3 (DO), U$12.4 (DI)
unnamed: U$11.2 (CO), U$12.5 (CI)
unnamed: U$12.3 (DO), U$13.4 (DI)
unnamed: U$12.2 (CO), U$13.5 (CI)
unnamed: U$13.3 (DO), U$14.4 (DI)
unnamed: U$13.2 (CO), U$14.5 (CI)
unnamed: U$14.3 (DO), U$15.4 (DI)
unnamed: U$14.2 (CO), U$15.5 (CI)
unnamed: U$15.3 (DO), U$16.4 (DI)
unnamed: U$15.2 (CO), U$16.5 (CI)
unnamed: U$16.3 (DO), U$17.4 (DI)
unnamed: U$32.3 (DO), U$33.4 (DI)
unnamed: U$17.3 (DO), U$18.4 (DI)
unnamed: U$17.2 (CO), U$18.5 (CI)
unnamed: U$18.3 (DO), U$19.4 (DI)
unnamed: U$18.2 (CO), U$19.5 (CI)
unnamed: U$19.3 (DO), U$20.4 (DI)
unnamed: U$19.2 (CO), U$20.5 (CI)
unnamed: U$20.3 (DO), U$21.4 (DI)
unnamed: U$20.2 (CO), U$21.5 (CI)
unnamed: U$21.3 (DO), U$22.4 (DI)
unnamed: U$21.2 (CO), U$22.5 (CI)
unnamed: U$22.3 (DO), U$23.4 (DI)
unnamed: U$22.2 (CO), U$23.5 (CI)
unnamed: U$23.3 (DO), U$24.4 (DI)
unnamed: U$23.2 (CO), U$24.5 (CI)
unnamed: U$24.3 (DO), U$25.4 (DI)
unnamed: U$24.2 (CO), U$25.5 (CI)
unnamed: U$25.3 (DO), U$26.4 (DI)
unnamed: U$25.2 (CO), U$26.5 (CI)
unnamed: U$26.3 (DO), U$27.4 (DI)
unnamed: U$26.2 (CO), U$27.5 (CI)
unnamed: U$27.3 (DO), U$28.4 (DI)
unnamed: U$27.2 (CO), U$28.5 (CI)
unnamed: U$28.3 (DO), U$29.4 (DI)
unnamed: U$28.2 (CO), U$29.5 (CI)
unnamed: U$29.3 (DO), U$30.4 (DI)
unnamed: U$29.2 (CO), U$30.5 (CI)
unnamed: U$30.3 (DO), U$31.4 (DI)
unnamed: U$30.2 (CO), U$31.5 (CI)
unnamed: U$31.3 (DO), U$32.4 (DI)
unnamed: U$31.2 (CO), U$32.5 (CI)
unnamed: U$1.4 (DI), U$47.3 (DO)
unnamed: U$1.5 (CI), U$47.2 (CO)
unnamed: U$33.3 (DO), U$34.4 (DI)
unnamed: U$16.2 (CO), U$17.5 (CI)
unnamed: U$33.2 (CO), U$34.5 (CI)
unnamed: U$34.3 (DO), U$35.4 (DI)
unnamed: U$34.2 (CO), U$35.5 (CI)
unnamed: U$35.3 (DO), U$36.4 (DI)
unnamed: U$35.2 (CO), U$36.5 (CI)
unnamed: U$36.3 (DO), U$37.4 (DI)
unnamed: U$36.2 (CO), U$37.5 (CI)
unnamed: U$37.3 (DO), U$38.4 (DI)
unnamed: U$37.2 (CO), U$38.5 (CI)
unnamed: U$38.3 (DO), U$39.4 (DI)
unnamed: U$38.2 (CO), U$39.5 (CI)
unnamed: DO.1, U$39.3 (DO)
unnamed: CO.1, U$39.2 (CO)
unnamed: U$40.3 (DO), U$41.4 (DI)
unnamed: U$40.2 (CO), U$41.5 (CI)
unnamed: U$41.3 (DO), U$42.4 (DI)
unnamed: U$41.2 (CO), U$42.5 (CI)
unnamed: U$42.3 (DO), U$43.4 (DI)
unnamed: U$42.2 (CO), U$43.5 (CI)
unnamed: U$43.3 (DO), U$44.4 (DI)
unnamed: U$43.2 (CO), U$44.5 (CI)
unnamed: U$44.3 (DO), U$45.4 (DI)
unnamed: U$44.2 (CO), U$45.5 (CI)
unnamed: U$45.3 (DO), U$46.4 (DI)
unnamed: U$45.2 (CO), U$46.5 (CI)
unnamed: U$46.3 (DO), U$47.4 (DI)
unnamed: U$46.2 (CO), U$47.5 (CI)
unnamed: CI.1, U$40.5 (CI)
unnamed: DI.1, U$40.4 (DI)
unnamed: U$32.2 (CO), U$33.5 (CI)

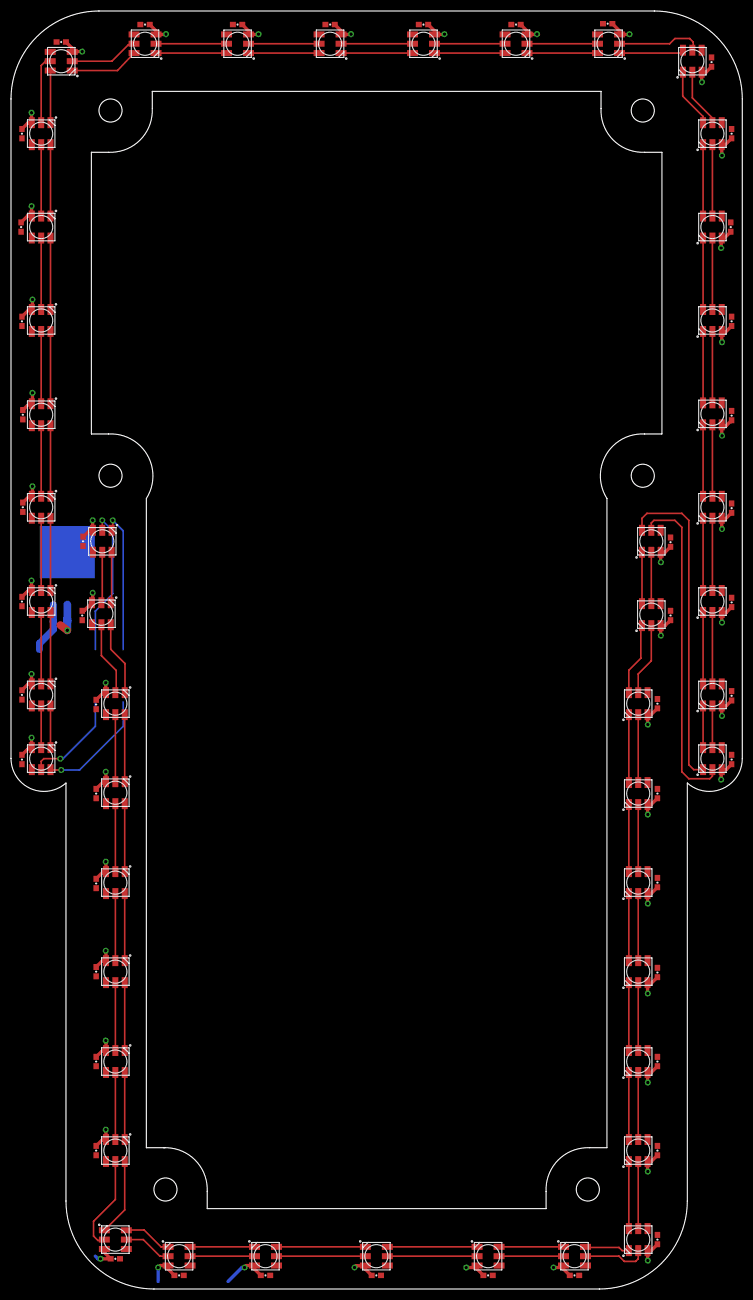
[picture p23: board SBX_connector_outline.brd from above]

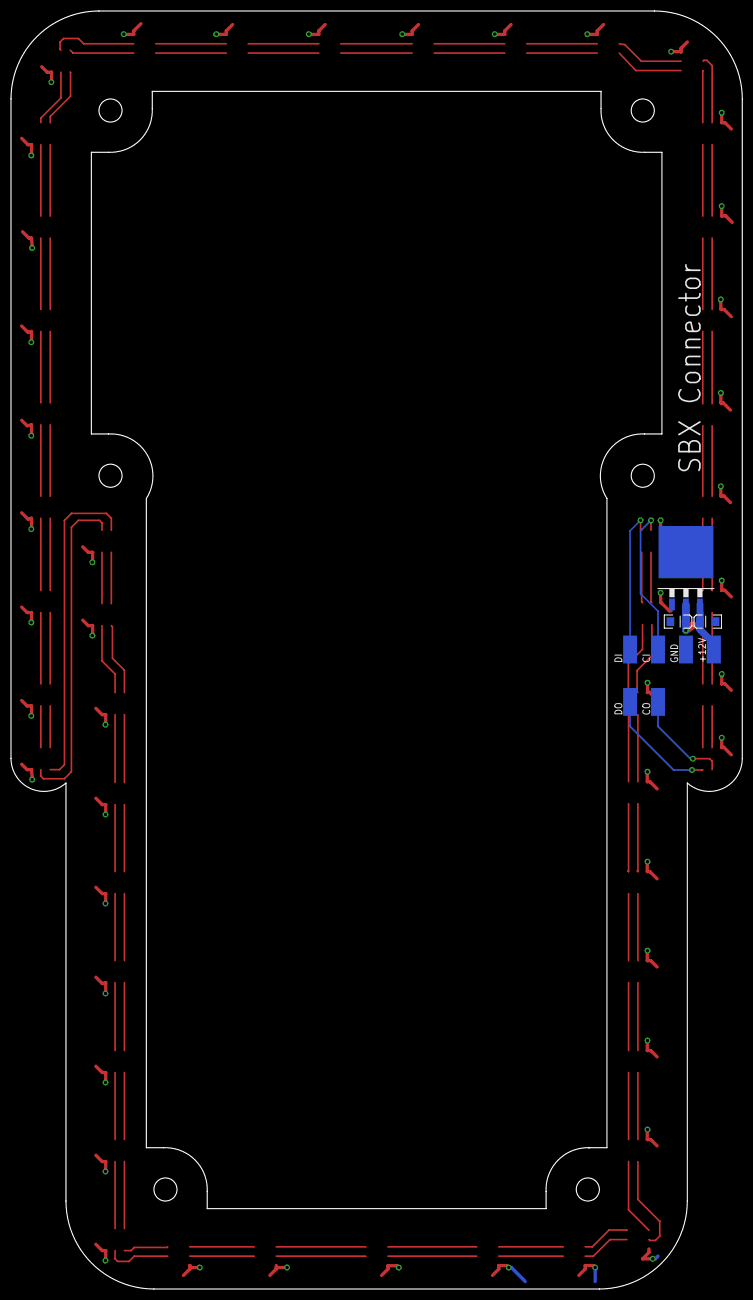
[picture p24: board SBX_connector_outline.brd from below]

Board: 2 copper layers, 133.0 x 232.4 mm, 103 parts (9 on the bottom side), 99 nets.
