grantHarris/ProsthesisBatteryPack/Firmware/battery-interface/battery-interface.ino

#include <FlexCAN.h>
#include <FastLED.h>
#include <Bounce.h>

#include <kinetis_flexcan.h>

#include <Scheduler.h>
#include "battery-interface.h"

void setup(void)
{
	Serial.begin(9600);
	Scheduler.start(CAN::setup, CAN::read);
	Scheduler.start(Inputs::setup, Inputs::read);
	Scheduler.start(Indicators::setup, Indicators::update);
	Scheduler.start(Buzzer::setup, Buzzer::update);
}


void loop(void)
{
}
