grantHarris/ProsthesisBatteryPack/Firmware/battery-interface/Pins.h

//Buzzer
#define BUZZER_PIN 10

//Fan PWM Pin
#define FAN_PWM_PIN 23

//SBX Sense
#define SBX_SENSE_RIGHT_PIN 7
#define SBX_SENSE_LEFT_PIN 8

//Contactor Closed Sense
#define CONTACTOR_SENSE_RIGHT_PIN 19
#define CONTACTOR_SENSE_LEFT_PIN 18

//Precharge Enable Sense
#define PRECHARGE_EN_SENSE_RIGHT_PIN 17
#define PRECHARGE_EN_SENSE_LEFT_PIN 16

//Charge Sense
#define CHARGE_SENSE_RIGHT_PIN 15
#define CHARGE_SENSE_LEFT_PIN 14

//LED
#define LED_DATA_PIN     11
#define LED_CLOCK_PIN    13

//Fan LED Strip
#define FAN_R_PIN 9
#define FAN_G_PIN 6
#define FAN_B_PIN 5

//Pack LED Strip
#define PACK_R_PIN 20
#define PACK_G_PIN 21
#define PACK_B_PIN 22
