grantHarris/ProsthesisBatteryPack/Firmware/battery-interface/Indicators.cpp

#include "Indicators.h"
#include "Inputs.h"

namespace Indicators {
    CRGB buf[NUM_LEDS];

    CRGB smoothedBuf[NUM_LEDS];

    // SOC Map
    LEDSection *socLeftBracket;     LEDSection *socLeftArrow;
    LEDSection *socRightBracket;    LEDSection *socRightArrow;
    LEDSection *levels[11];

    // SBX Map
    LEDSection *sbxRightUpper;      LEDSection *sbxRightLower;
    LEDSection *sbxLeftUpper;       LEDSection *sbxLeftLower;

    // ARROWS
    LEDSection *arrowRight;         LEDSection *arrowLeft;

    SBXConnector *sbxRight;
    SBXConnector *sbxLeft;

    // SmoothedControls
    float smoothedSOCPercentage = 0.;
    float smoothedSBXRightState = 0.;
    float smoothedSBXLeftState = 0.;
  
    void setup()
    {  
        pinMode(FAN_R_PIN, OUTPUT);
        pinMode(FAN_G_PIN, OUTPUT);
        pinMode(FAN_B_PIN, OUTPUT);

        pinMode(PACK_R_PIN, OUTPUT);
        pinMode(PACK_G_PIN, OUTPUT);
        pinMode(PACK_B_PIN, OUTPUT);

        FastLED.addLeds<APA102, LED_DATA_PIN, LED_CLOCK_PIN, COLOR_ORDER, DATA_RATE_MHZ(6)>(buf, NUM_LEDS).setCorrection(TypicalLEDStrip);
    
        // Mapping
        setupMapping();

        // Initialize Smoothed Controls
        smoothedSOCPercentage = 0.;
        smoothedSBXRightState = 0.;
        smoothedSBXLeftState = 0.;

        // Setup SBX Colors
        sbxRightUpper->setColor(CHSV(0,0,0));
        sbxRightLower->setColor(CHSV(0,0,0));
        sbxLeftUpper->setColor(CHSV(0,0,0));
        sbxLeftLower->setColor(CHSV(0,0,0));
        
         // Setup level colors
        for( int i = 0; i < 2; i++) levels[i]->setColor(CHSV(0,255,150));     // Red
        for( int i = 2; i < 3; i++) levels[i]->setColor(CHSV(60,255,150));    // Yellow
        for( int i = 3; i < 11; i++) levels[i]->setColor(CHSV(97,255,150));   // Green

        sbxRight = new SBXConnector(sbxRightLower, sbxRightUpper);
        sbxLeft = new SBXConnector(sbxLeftLower, sbxLeftUpper);
    }
  
    void setSOC(uint8_t percentage)
    { 
        float alpha = 0.0075;
        smoothedSOCPercentage = ((1-alpha) * smoothedSOCPercentage) + (alpha * (float)percentage);
    }
  
    void update()
    {
        sbxRight->setInsertionState(Inputs::isSbxRightPresent());
        sbxLeft->setInsertionState(Inputs::isSbxLeftPresent());
        
        sbxRight->setContactorState(Inputs::isContactorRightClosed());
        sbxLeft->setContactorState(Inputs::isContactorLeftClosed());


        if(CAN::isCurrent()){
            pack_t pack = CAN::getPackState();
            setSOC(pack.soc);
            
            //CAN::temp_t temp = CANFoo::getTempState();
        }else{
             /* 
                 No CAN data or outdated data. Can't display state of charge, temperature, etc
                 Display error on display
             */
            Serial.println("No CAN data!");
        }

        updateIndicators();

        FastLED.show();
        FastLED.delay(1000 / UPDATES_PER_SECOND);
        yield();
    }

  void updateIndicators()
  {   
    // Just Set the brackets to the color of the battery level (for now?)
    int batteryLevelIdx = smoothedSOCPercentage/10 + 1;

    // SOC
    // Now turn off some of the levels (abstract to a draw later/next)
    for (int i = 0; i < 11; i++) {
      levels[i]->clear();
    } 
    for (int i = 0; i <= batteryLevelIdx; i++) {
      levels[i]->render();
    }

    // Update color 
    socLeftBracket->renderColorFill(levels[batteryLevelIdx]->color);
    socLeftArrow->renderColorFill(levels[batteryLevelIdx]->color);
    socRightBracket->renderColorFill(levels[batteryLevelIdx]->color);
    socRightArrow->renderColorFill(levels[batteryLevelIdx]->color); 
       
    // SBX
    sbxRightUpper->render();
    sbxRightLower->render();
    sbxLeftUpper->render();
    sbxLeftLower->render();

    // ARROWS
  }
  
  // --------------------------------------------------------------
  // LED SECTION

  LEDSection::LEDSection(uint16_t _offset, uint16_t _size){
    size = _size;
    offset = _offset;
    color = CHSV(0,0,0);
    map = new uint16_t[size];
    for (int i = 0; i < size; i++)  map[i] = i;
  }

  void LEDSection::setColor(CHSV _color){
    color = _color;    
  }

  void LEDSection::clear(){
    for(int i = 0; i < size; i++) {
      buf[offset + map[i]] = CHSV(0,0,0);   
    }    
  }

  void LEDSection::render(){
    for(int i = 0; i < size; i++) {
      buf[offset + map[i]] = color;   
    } 
  }

  void LEDSection::renderColorFill(CHSV _color){
    color = _color;
    for(int i = 0; i < size; i++) {
      buf[offset + map[i]] = _color;   
    } 
  }

  // LED MAPPING
  void setupMapping() {
    uint8_t i;

    // SBX (SBX is type of connector)  
    uint8_t sbxRightOffset = 0;   
    sbxRightUpper = new LEDSection(sbxRightOffset + 0, 23);
    sbxRightLower = new LEDSection(sbxRightOffset + 23, 24);

    uint8_t sbxLeftOffset = 125;
    sbxLeftUpper = new LEDSection(sbxLeftOffset + 0, 23);
    sbxLeftLower = new LEDSection(sbxLeftOffset + 23, 24);    

    // STATE OF CHARGE INDICATOR (SOC)
    uint8_t socOffset = 47;

    // LEFT BRACKET 
    socLeftBracket = new LEDSection(socOffset + 0, 12);
    // skips some LEDs, mapping adjust)
    for ( i = 6; i < 12; i++) socLeftBracket->map[i] = i+4;

    // LEFT ARROW
    socLeftArrow = new LEDSection(socOffset + 6, 4);

    // RIGHT BRACKET
    socRightBracket = new LEDSection(socOffset + 16, 12);
    
    // skips some LEDs, mapping adjust)
    for ( i = 6; i < 12; i++) socRightBracket->map[i] = i+4;

    // RIGHT ARROW
    socRightArrow = new LEDSection(socOffset + 22, 4);

    // LEVELS
    levels[0] = new LEDSection(socOffset + 32, 2);
    levels[1] = new LEDSection(socOffset + 34, 4);   
    levels[2] = new LEDSection(socOffset + 38, 4);  
    levels[3] = new LEDSection(socOffset + 42, 4);        
    levels[4] = new LEDSection(socOffset + 46, 4);
    levels[5] = new LEDSection(socOffset + 50, 4);
    levels[6] = new LEDSection(socOffset + 54, 4);
    levels[7] = new LEDSection(socOffset + 58, 5);   
    levels[8] = new LEDSection(socOffset + 63, 5);
    levels[9] = new LEDSection(socOffset + 68, 5);        
    levels[10] = new LEDSection(socOffset + 73, 5);
  }

  //SBX Connector

  SBXConnector::SBXConnector(LEDSection *sbxLower, LEDSection *sbxUpper) {
    _sbxLower = sbxLower;
    _sbxUpper = sbxUpper;
  }

  void SBXConnector::setInsertionState(bool state) {
    if(state){
      _sbxLower->setColor(CHSV(60,255,255));
    }else{
     _sbxLower->setColor(CHSV(0,0,0)); 
    }
  }

  void SBXConnector::setContactorState(bool state) {
    if(state){
      _sbxUpper->setColor(CHSV(0,255,150));
    }else{
     _sbxUpper->setColor(CHSV(0,0,0)); 
    }
  }



  
 };
