grantHarris/ProsthesisBatteryPack/Firmware/battery-interface/Indicators.h

#ifndef __Indicators_H__
#define __Indicators_H__

#include <Arduino.h>
#include <FastLED.h>

#include "Pins.h"
#include "CAN.h"

#define NUM_LEDS 188

#define COLOR_ORDER BGR
#define UPDATES_PER_SECOND 100

namespace Indicators {	
	void setup();
  void setupMapping();
  
  void update();
  void updateIndicators();
  
	void setSOC(uint8_t percentage);
	void setSBXState(uint8_t sbx, bool state);
  
  class LEDSection {
    public:
      LEDSection(uint16_t _offset, uint16_t _size);
      void setColor(CHSV _color);
      void render();
      void renderColorFill(CHSV _color);
      void clear();

      CHSV color;
      uint16_t *map;
      
    private:
      uint16_t offset;
      uint16_t size;
  };

  class SBXConnector {
    public:
      SBXConnector(LEDSection *sbxLower, LEDSection *sbxUpper);
      void setInsertionState(bool state);
      void setContactorState(bool state);
    private:
      LEDSection *_sbxLower;
      LEDSection *_sbxUpper;
  };
}
#endif // __Indicators_H__
