grantHarris/ProsthesisBatteryPack/(commit log)

2016-11-01 Existing boards
    [SOC level indicator.brd, SOC level indicator.sch, power indicator_right.brd, power indicator_right.sch]
2016-11-02 No airwires
    [SOC level indicator.brd, SOC level indicator.sch]
2016-11-12 SOC level indicator
    [SOC level indicator.brd, SOC level indicator.sch]
2016-11-12 Updated SOC_level_indicator
    [SOC_level_indicator.brd, SOC_level_indicator.sch]
2016-11-12 Latest light panel pcb files
    [SBX_connector_outline_right.brd, SBX_connector_outline_right.sch, power_indicator_left.brd, power_indicator_left.sch, power_indicator_right.brd, power_indicator_right.sch]
2016-11-13 Power indicators more or less done
    [power_indicator_left.brd, power_indicator_right.brd, power_indicator_right.sch]
2016-11-14 Right connector rename and fix up import
    [SBX_connector_outline.brd, SBX_connector_outline.sch]
2016-11-15 SBX_connector_outline board complete
    [SBX_connector_outline.brd, SBX_connector_outline.sch]
2016-11-16 Clean up light panels. Remvoe names/values
    [SBX_connector_outline.brd, SBX_connector_outline.sch, SOC_level_indicator.brd, SOC_level_indicator.sch, power_indicator_left.brd, power_indicator_right.brd]
2016-11-26 Can shield
    [CANShield.brd, CANShield.sch]
2016-11-26 Most of the base board finished
    [CANShield.brd, CANShield.sch]
2016-12-01 precharge progress
    [CANShield.brd, CANShield.sch]
2016-12-05 down to one airwire
    [CANShield.brd, CANShield.sch]
2016-12-05 Mostly done
    [CANShield.brd, CANShield.sch]
2016-12-07 Feature complete pcb
    [CANShield.brd, CANShield.sch]
2016-12-24 Invert charged state
2016-12-27 Battery Pack LED Indicators - mapping SOC and SXB Indicators, LED sections and block color fill
2016-12-28 Inputs for precharge en should not be inverted
    [Inputs.cpp]
