grantHarris/ProsthesisBatteryPack/(notices)

Notices in the files:
parts and their libraries:
SparkFun-Capacitors: Licensing: Creative Commons ShareAlike 4.0 International - https://creativecommons.org/licenses/by-sa/4.0
SparkFun-Aesthetics: Licensing: CC v3.0 Share-Alike You are welcome to use this library for commercial purposes.
polyswitch: Copyright (C) 2008, Bob Starr
